kobuki-base/kobuki_resources/marketing/Turtlebot 2 complete kit price for Distributor_150720.pdf

Turtlebot 2 complete kit price for Distributor | 2015.07.20 Written by Min-su
Product | Specification | Quantity | Unit Price (USD) | Remark
Kobuki kit | | 1-99 ea | $280.00 | included Kobuki (base only) / Battery (4S1P) Adapter / USB cable (A type-B type)
| | 100 ea-299 ea | $250.00
| | over 300 ea | $230.00
Poles (include screw) | 14 ea / 1 set | 1 set | $13.00
Dummy Pipe | 2 ea / 1set | 1 set | $4.00
Disk | 3 ea / 1set | 1 set | $26.00
Asus Xtion Pro Mount | | 1 set | $7.00 | 1Disk + 2Poles(include screw)
Netbook | X200MA-KX681D | 1 ea | $450.00 | changeable by device EOL
| Software setting | 1 ea | $100.00
Netbook power cable | - | 1 ea | $10.00
3D sensor | Asus Xtion Pro | 1 ea | $260.00
Total for Turtlebot2 complete kit | | 1-99ea | US$1,150.00
| | 100 ea-299ea | US$1,120.00
| | over 300 ea | US$1,100.00

* Accessaries
Docking station | Docking station | 1 ea | $28.00 | Optional (not included complete kit)
Battery (4S2P) | Battery (4S2P) | 1 ea | $48.00
Caster Wheel | Caster Wheel | 1 Set | $8.00
