kobuki-base/kobuki_resources/hardware/customisations/kobuki_psd_array_brk_90.jpg

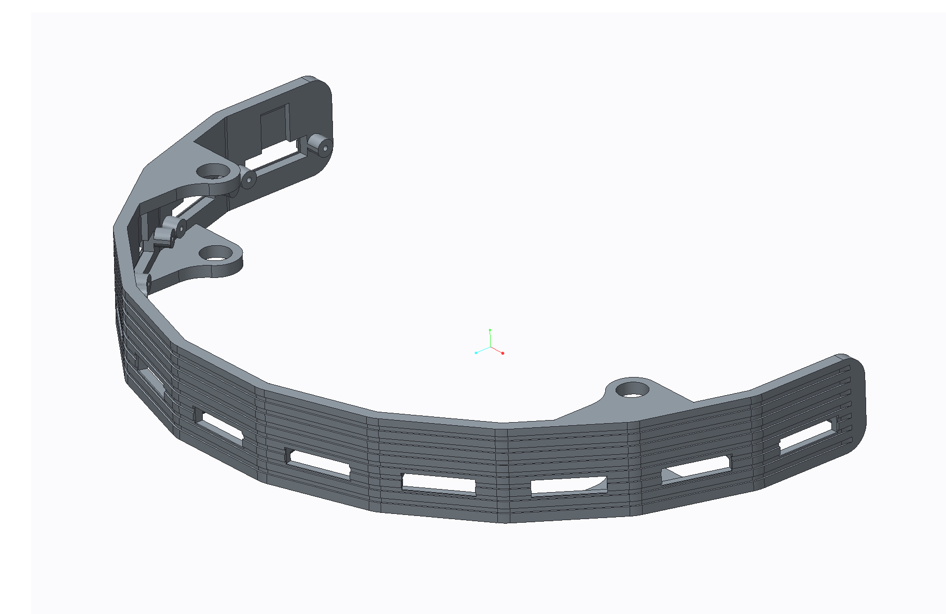
hardware/customisations/kobuki_psd_array_brk_90.jpg
