kobuki-base/kobuki_resources/marketing/icra_roscon.jpg

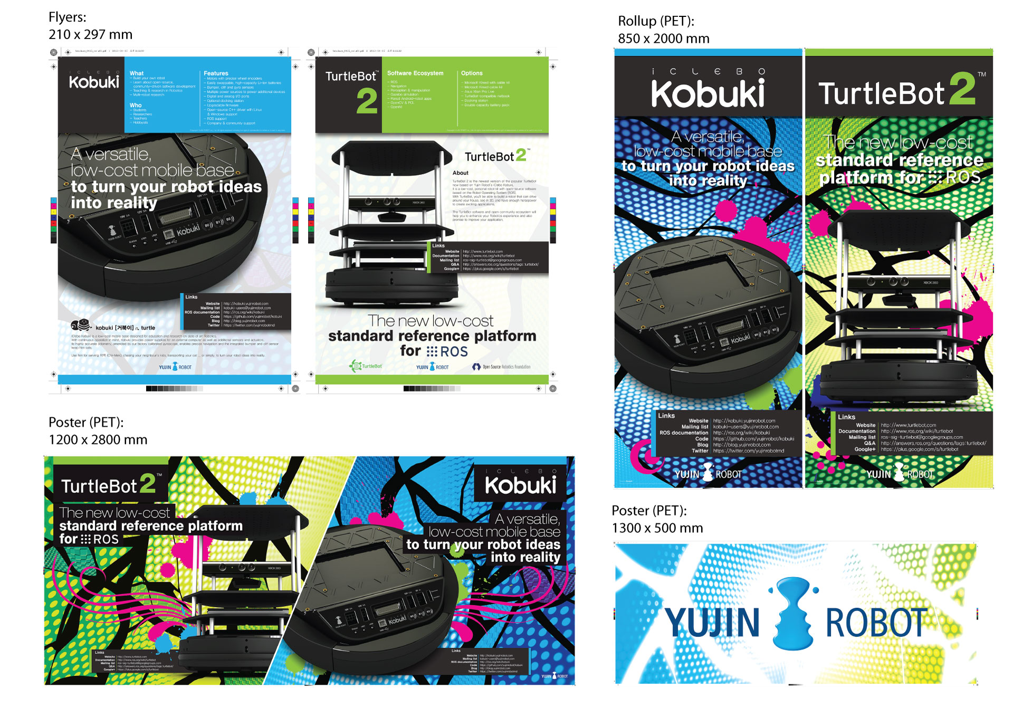
marketing/icra_roscon.jpg
