kobuki-base/kobuki_resources/media/08.jpg

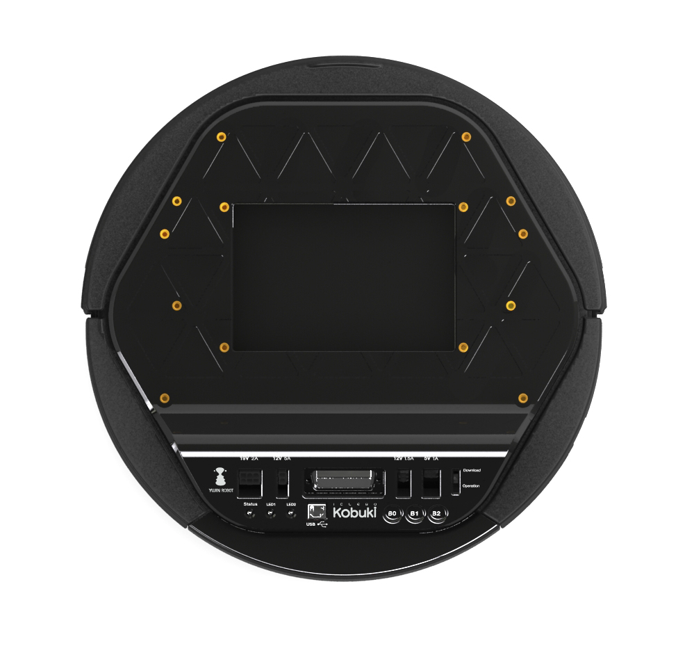
media/08.jpg
