kobuki-base/kobuki_resources/media/big_battery_pack_4S2P.jpg

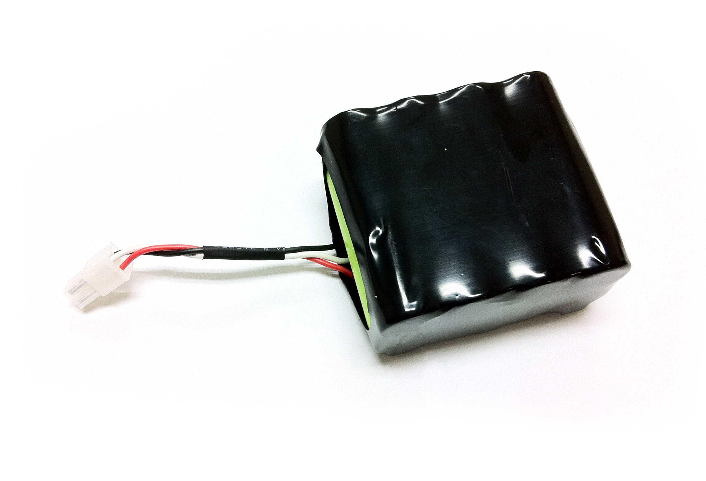
media/big_battery_pack_4S2P.jpg
