kobuki-base/kobuki_resources/media/bottom.jpg

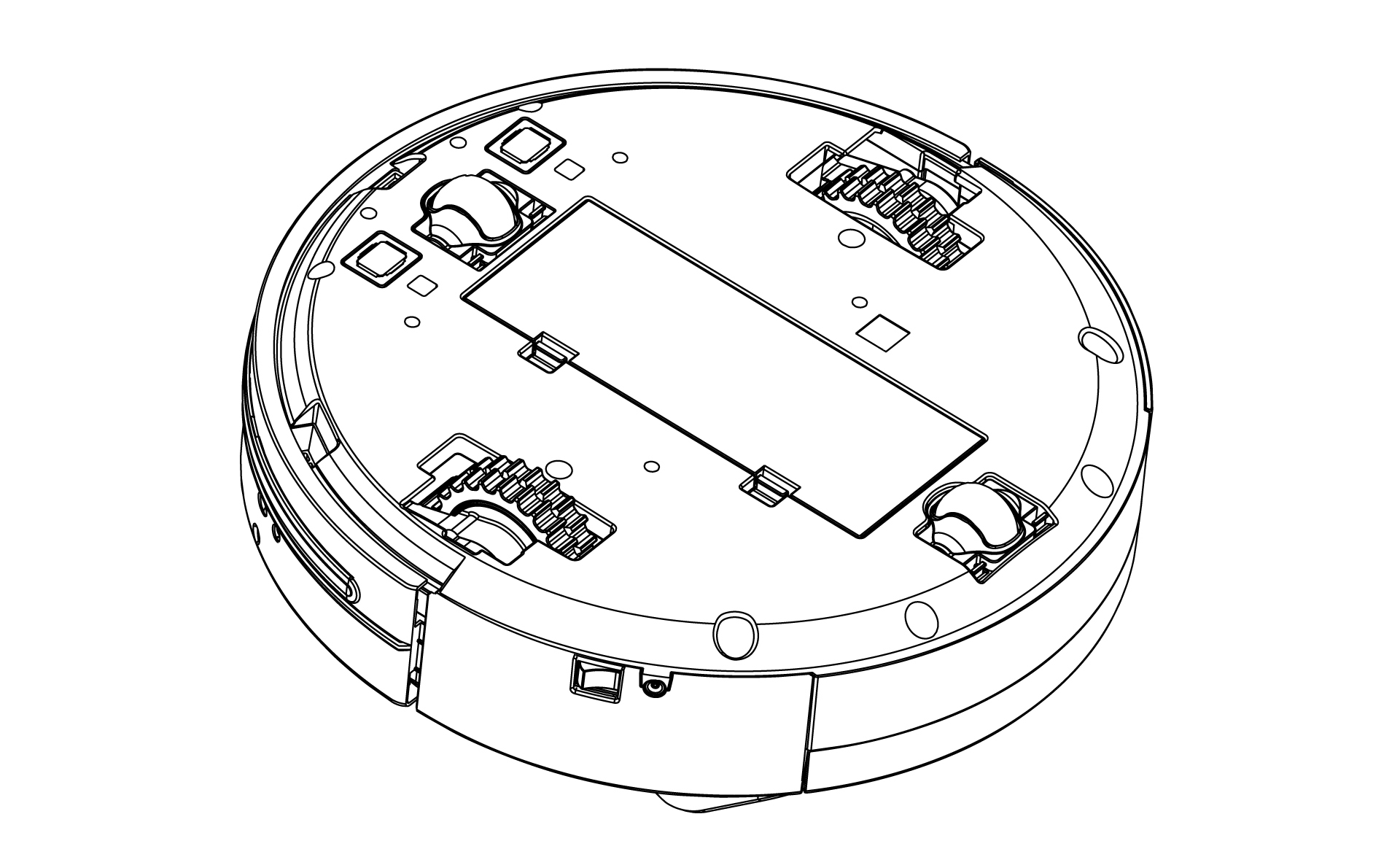
media/bottom.jpg
