kobuki-base/kobuki_resources/media/docking_station_01.jpg

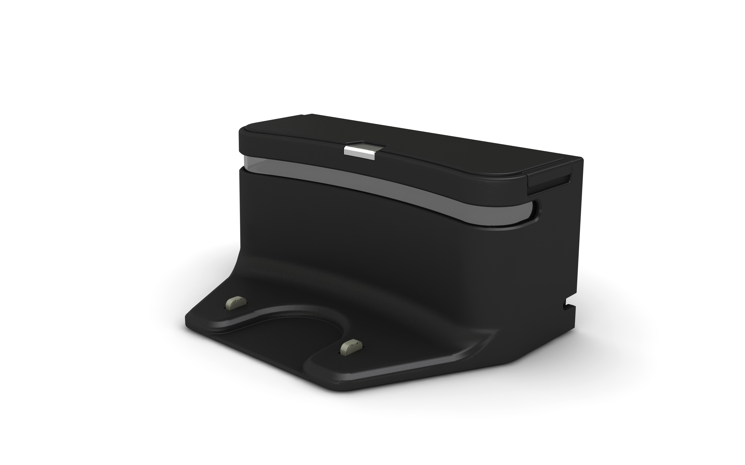
media/docking_station_01.jpg
