kobuki-base/kobuki_resources/media/docking_station_02.jpg

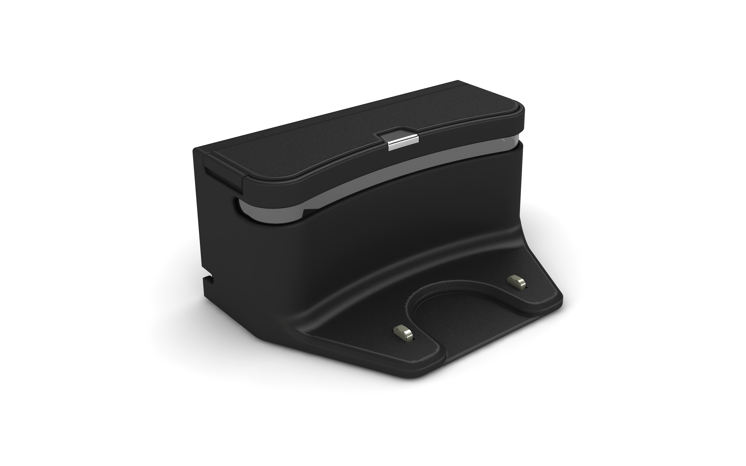
media/docking_station_02.jpg
