kobuki-base/kobuki_resources/media/high-resolution/kobuki-rendering.jpg

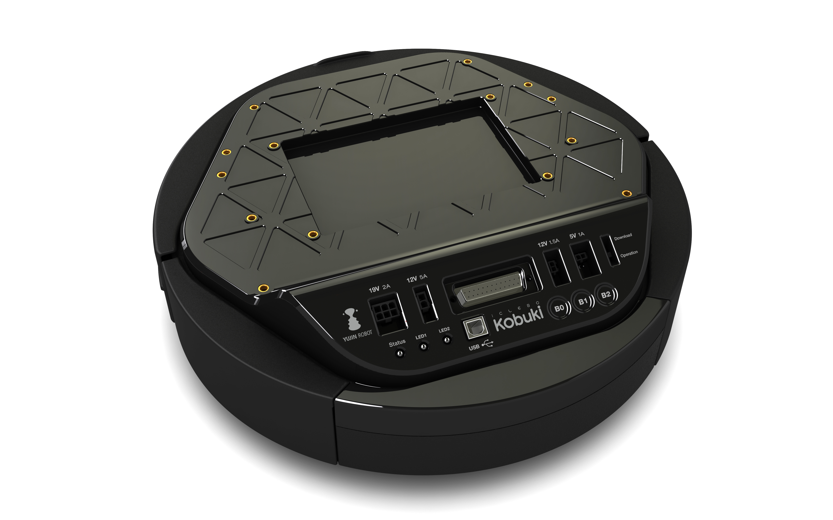
media/high-resolution/kobuki-rendering.jpg
