kobuki-base/kobuki_resources/media/kobuki-rendering.png

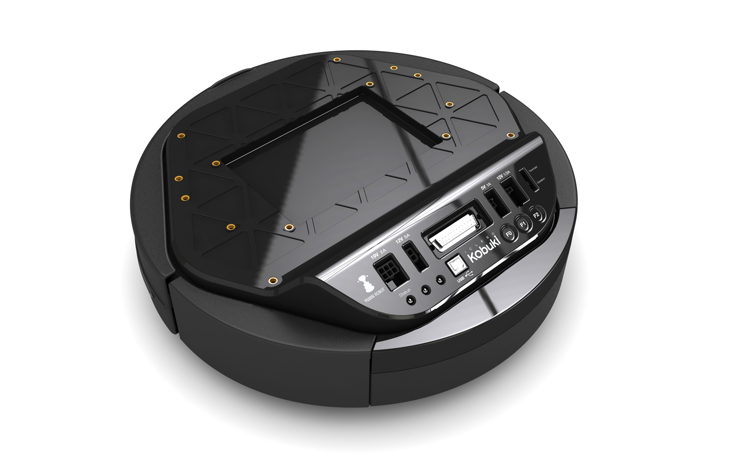
media/kobuki-rendering.png
