kobuki-base/kobuki_resources/media/kobuki_iso_view_01.png

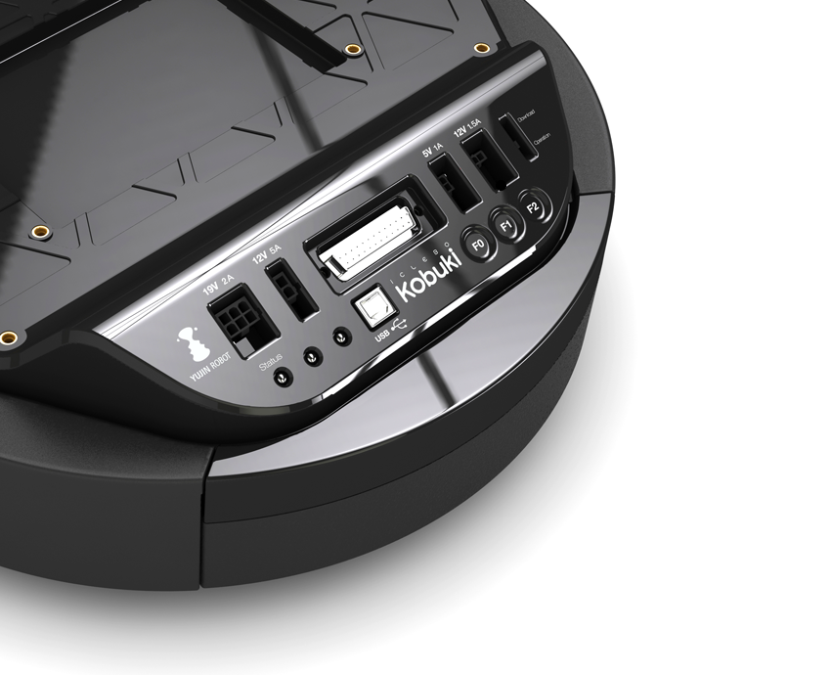
media/kobuki_iso_view_01.png
