kobuki-base/kobuki_resources/media/kobuki_iso_view_02.png

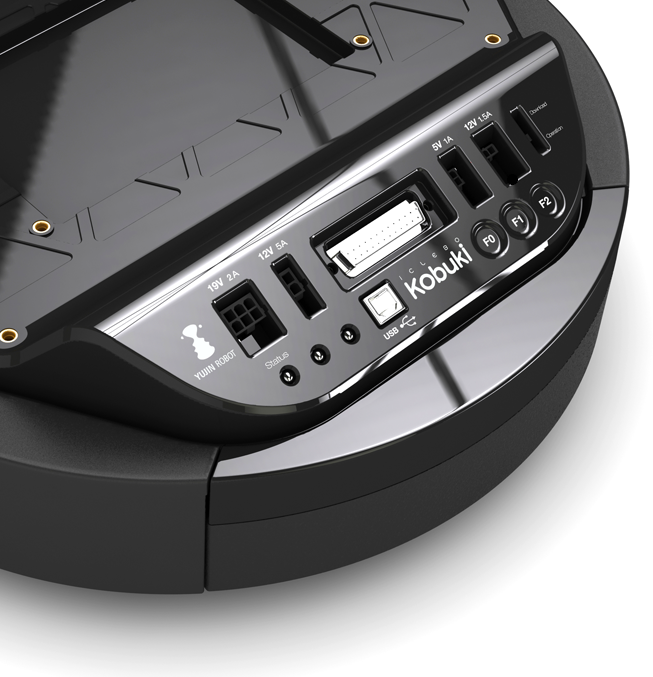
media/kobuki_iso_view_02.png
