kobuki-base/kobuki_resources/media/small_battery_pack_4S1P.jpg

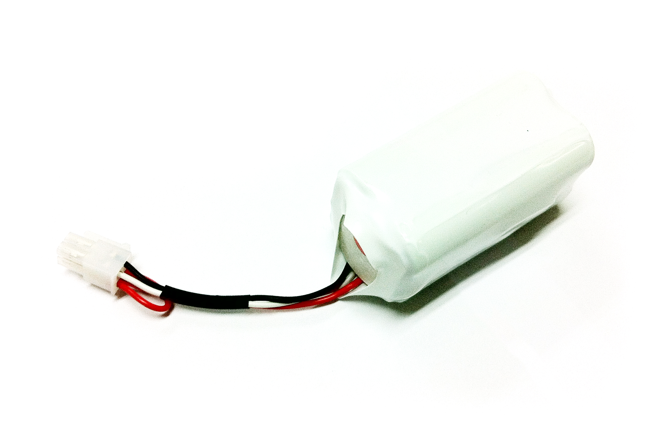
media/small_battery_pack_4S1P.jpg
