kobuki-base/kobuki_resources/media/top.jpg

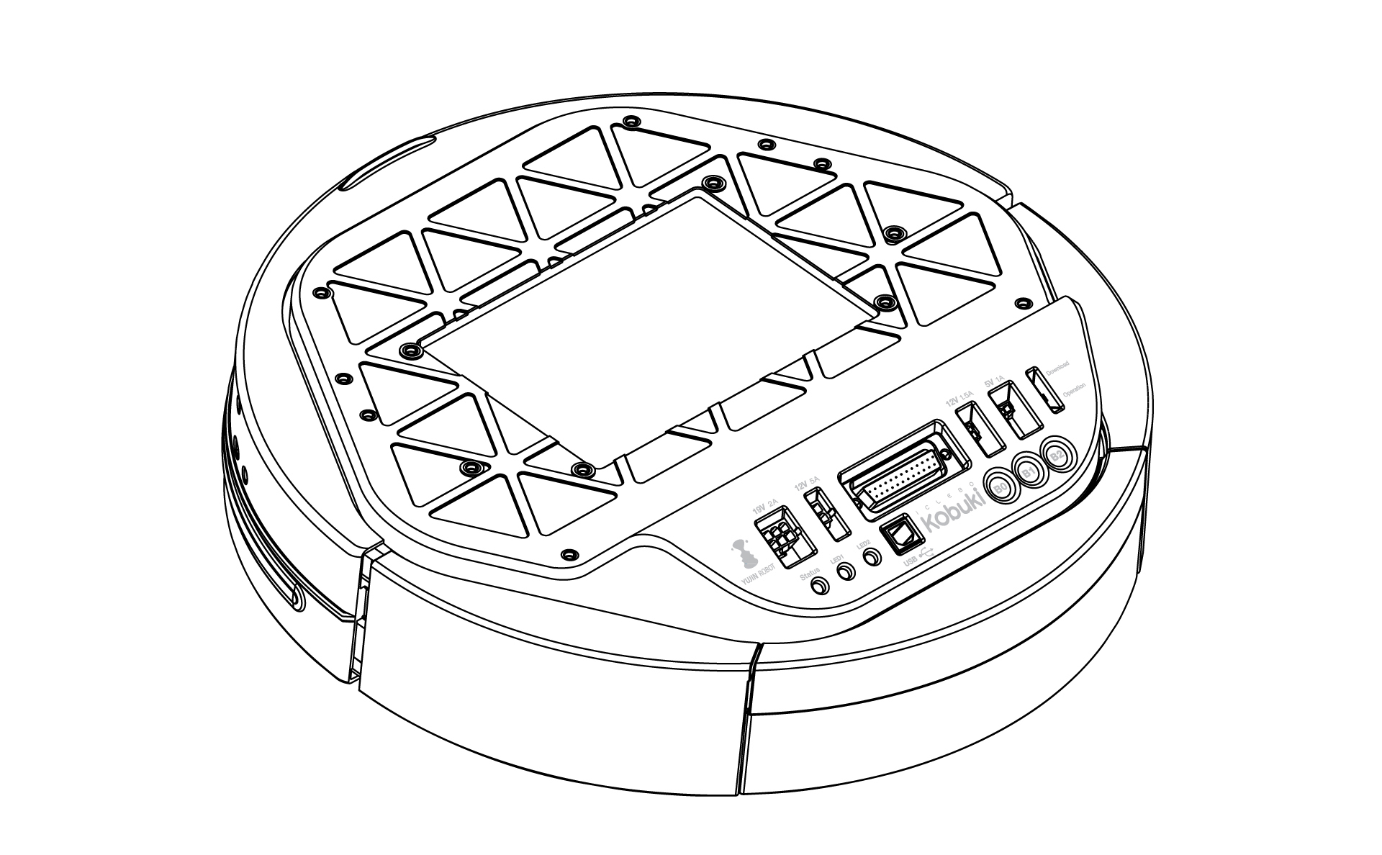
media/top.jpg
