kobuki-base/kobuki_resources/hardware/models/step/plate_bottom.stp

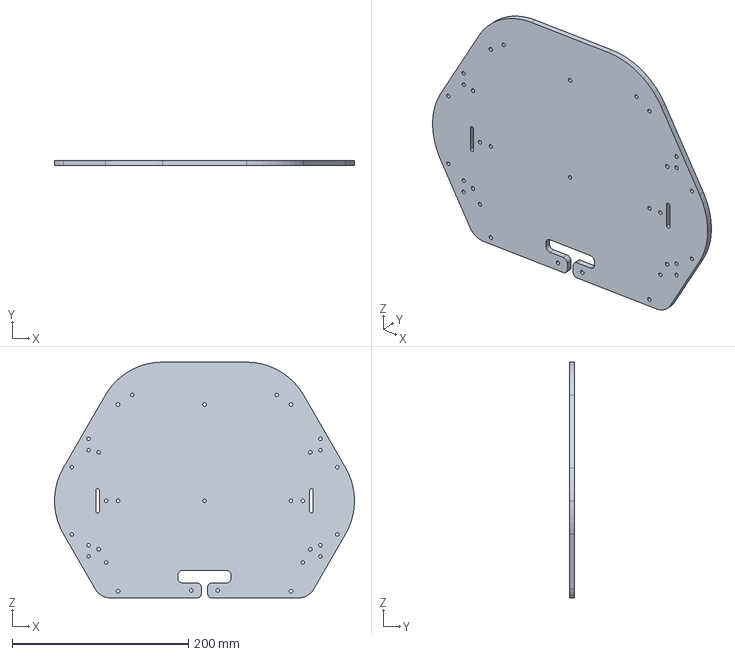
[picture p16: CAD file, 2020-08-19]
hardware/models/step/plate_bottom.stp
340.0 x 6.00 x 267.3 mm
