kobuki-base/kobuki_resources/hardware/models/step/pole_middle.stp

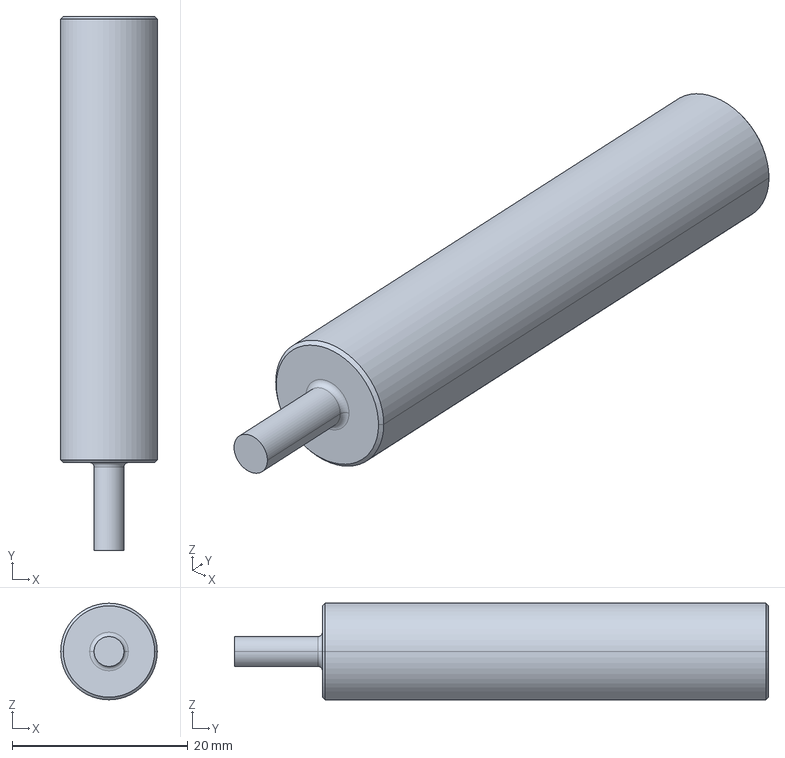
[picture p19: CAD file, 2020-08-19]
hardware/models/step/pole_middle.stp
11.0 x 60.8 x 11.0 mm
