kobuki-base/kobuki_resources/hardware/models/step/pole_bottom.stp

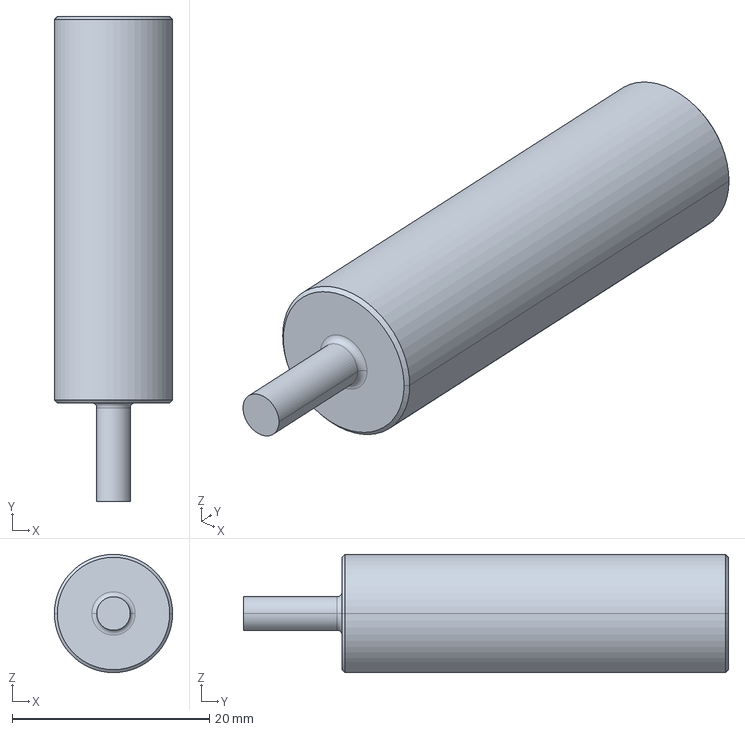
[picture p21: CAD file, 2020-08-19]
hardware/models/step/pole_bottom.stp
12.0 x 49.2 x 12.0 mm
