kobuki-base/kobuki_resources/hardware/models/step/plate_middle.stp

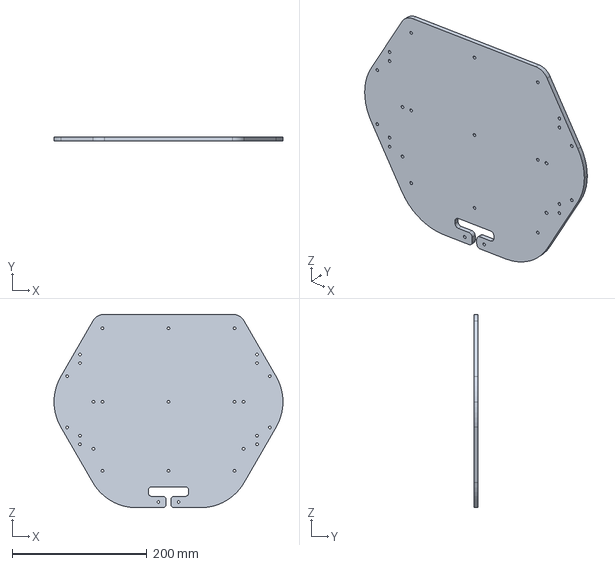
[picture p22: CAD file, 2020-08-19]
hardware/models/step/plate_middle.stp
340.0 x 6.00 x 287.3 mm
