kobuki-base/kobuki_resources/hardware/models/step/kobuki.stp

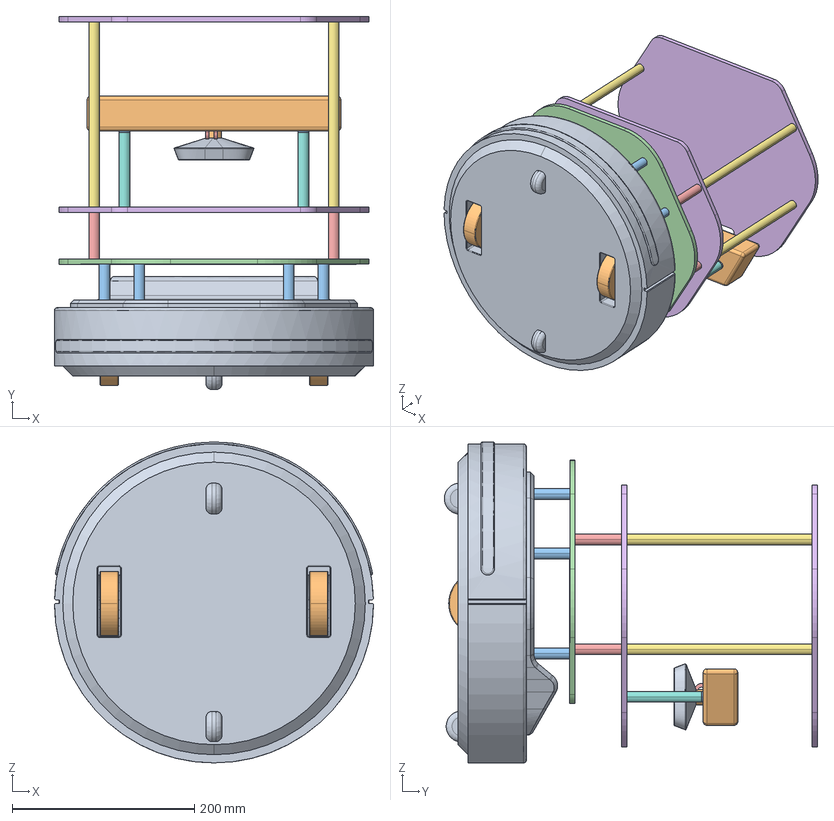
[picture p24: CAD file, 2020-08-19]
hardware/models/step/kobuki.stp
350.0 x 409.6 x 352.0 mm
MAIN_BODY
MAIN_WHEEL_R
MAIN_WHEEL_L
1F_POLL x 6
1F_STACK
2F_POLL x 4
2F_STACK
3F_POLL x 4
3F_STACK
KINECT_POLL x 2
KINECT_M
XTION_POLL x 2
XTION_BRK
XTION-PRO-CAMERA
