kobuki-base/kobuki_resources/(list of files, cad)

Other CAD files:
hardware/drawings/dwg/counterweight.dwg
hardware/drawings/dwg/plate_middle.dwg
hardware/drawings/dwg/pole_top.dwg
hardware/drawings/dwg/pole_kinect.dwg
hardware/drawings/dwg/pole_middle.dwg
hardware/drawings/dwg/pole_bottom.dwg
hardware/drawings/dwg/plate_bottom.dwg
hardware/drawings/dwg/plate_top.dwg
hardware/models/igs/counterweight.igs
hardware/models/igs/plate_bottom.igs
hardware/models/igs/plate_middle.igs
hardware/models/igs/plate_top.igs
hardware/models/igs/pole_bottom.igs
hardware/models/igs/pole_kinect.igs
hardware/models/igs/pole_middle.igs
hardware/models/igs/pole_top.igs
