kobuki-base/kobuki_resources/marketing/kobuki_quickguide_a3.pdf

# Introducing Korea’s First Robotic Turtle!

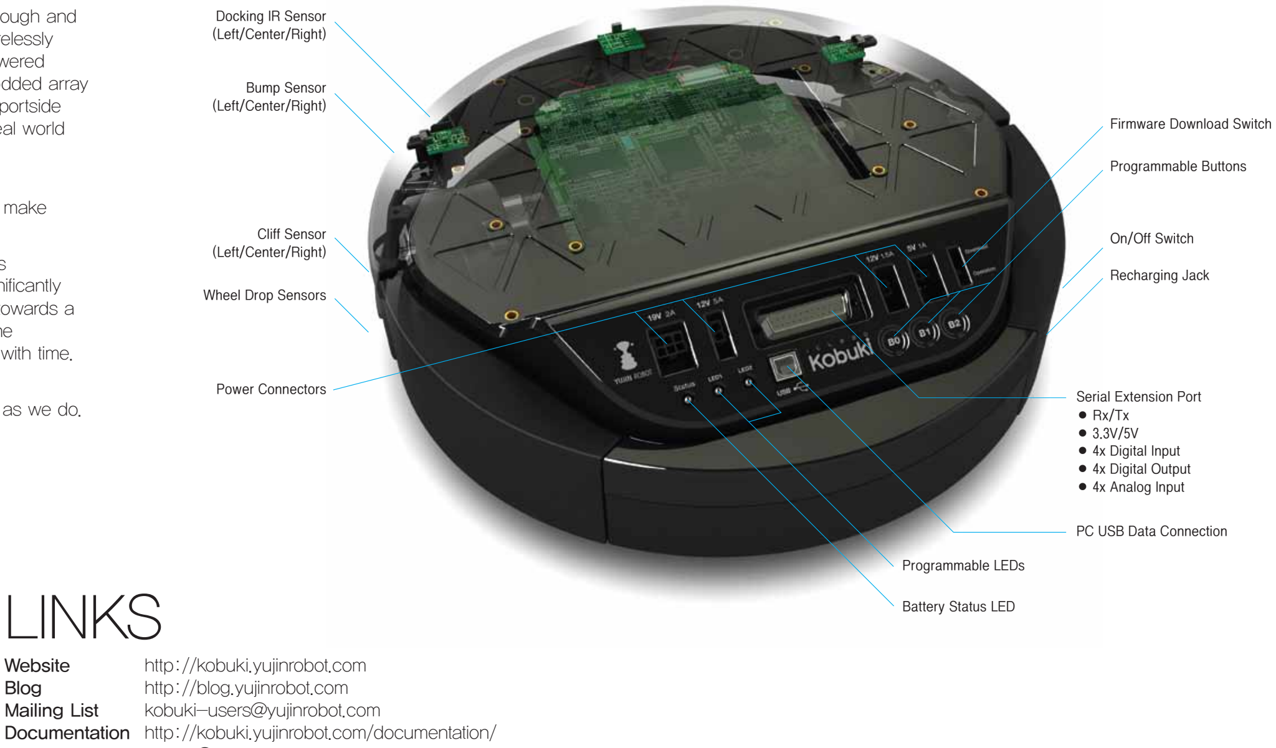
[picture p25: figure]
Recharging Jack; On/Off Switch; Firmware Download Switch; Programmable Buttons; Serial Extension Port ● Rx/Tx ● 3.3V/5V ● 4x Digital Input ● 4x Digital Output ● 4x Analog Input; PC USB Data Connection; Programmable LEDs; Battery Status LED; Cliff Sensor (Left/Center/Right); Bump Sensor (Left/Center/Right); Docking IR Sensor (Left/Center/Right); Wheel Drop Sensors; Power Connectors; Documentation; http://kobuki.yujinrobot.com http://blog.yujinrobot.com kobuki-users@yujinrobot.com http://kobuki.yujinrobot.com/documentation/

Kobuki is robotically engineered to be long-lived, tough and fast. With high performance batteries, Kobuki will tirelessly work alongside you through those long coffee-powered nights. He will happily burden himself with your modded array of sensors, actuators, laptops, embedded boards, portside cannons and do it all at a speed that makes his real world cousins seem like... well, turtles.

# LINKS

Website
Blog
Mailing List

Contact
kobuki@yujinrobot.com
※ For more detailed information about Kobuki including safety instructions and troubleshooting, please check the online documentation.

# CONTENTS

1 x Kobuki
1 x 4S1P Li-Ion Battery
1 x Charger
1 x USB Cable
1 x Power Cable

MADE IN KOREA

Sensorly,
The Kobuki Team

We hope you enjoy working with Kobuki as much as we do.

Kobuki is still young, don’
now. Kobuki’
influenced by the community and as he marches towards a venerable old age, we will continue to work with the community and you to ensure he becomes better with time.

t expect him to remain as
s development has already been significantly

kobuki [거북이] . turtle n

Use him for serving 치맥 (Chi-Mek), chasing your neighbour’
your own robot ideas become reality.

s kids, transport your cat... or simply, to make
