kobuki-base/kobuki_resources/marketing/turtle_quickguide_a3.pdf

# TurtleBot 2

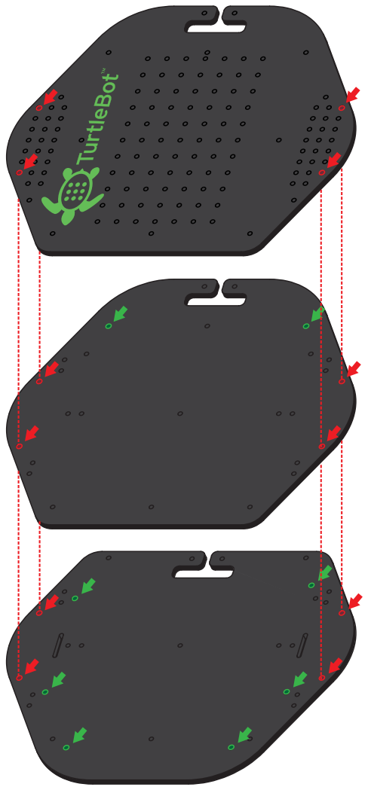
[picture p26: figure]

TurtleBot 2 is the newest version of the popular TurtleBot.
It is a low-cost, personal robot kit with open-source software. With TurtleBot, you'll be able to build a robot that can drive around your house, see in 3D, and have enough horsepower to create exciting applications.
The TurtleBot software and open community ecosystem will help you to enhance your Robotics experience and also promise to improve your application.

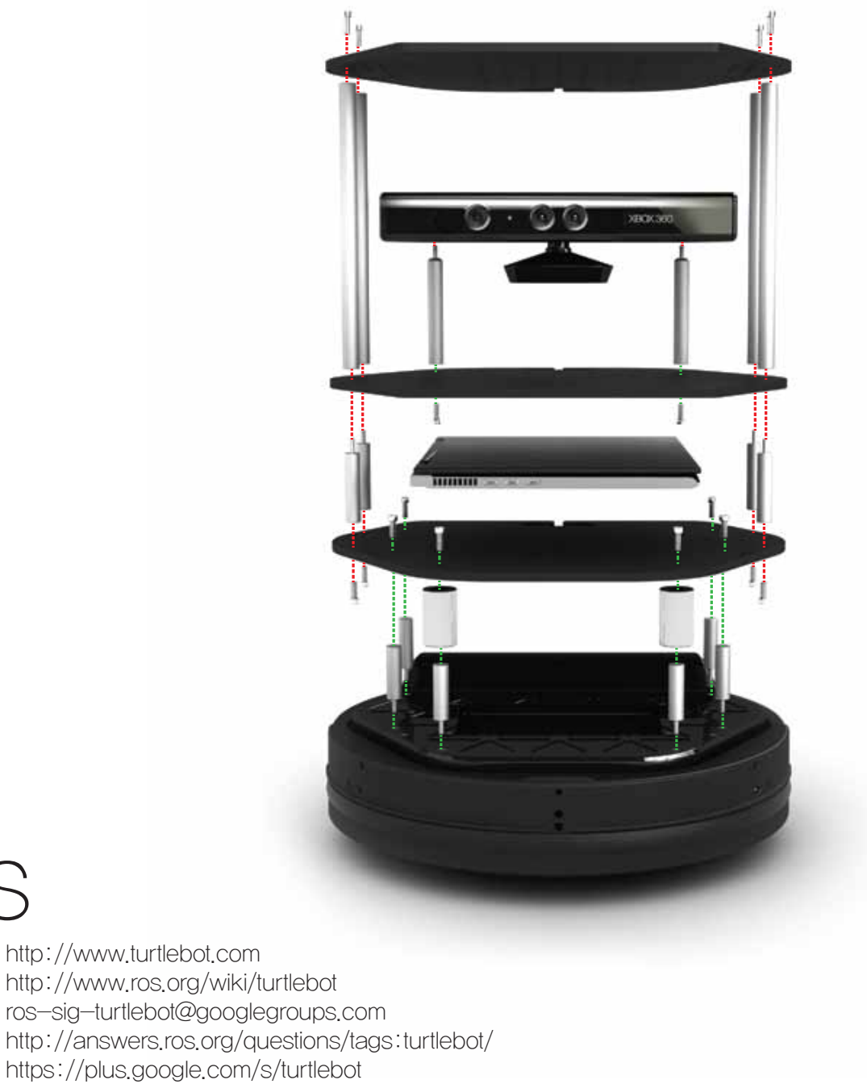
[picture p27: figure]
http://www.ros.org/wiki/turtlebot ros-sig-turtlebot@googlegroups.com; https://plus.google.com/s/turtlebot

# LINKS

Website
Documentation
Mailing List
Q/A
Blog

http://www.turtlebot.com

http://answers.ros.org/questions/tags:turtlebot/

# OPTIONS

Kinect with Modified Cable Kinect Cable Kit
Asus Xtion Pro
Turtlebot Compatible Netbook

# ABOUT

# CONTENTS

1 x Kobuki Complete Kit (Kobuki, Battery, Charger) 1 x Top Plate
1 x Middle Plate
1 x Bottom Plate
4 x 203mm Pole (Top)
4 x 50mm Pole (Middle)
6 x 39mm Pole (Bottom)
2 x 83mm Pole (3D Sensor)
2 x 200g Counterweight
16 x M4 Hex Socket Screw

TM
