kobuki-base/kobuki_resources/(threads)

Thread 1 (2021-01-18):

Docking station mesh?

emersonknapp, 2021-01-18:
I'm trying to build a gazebo plugin to simulate the docking station for the kobuki - it would be nice to have a 3d mesh to represent it accurately. Do you have these resources and could they be shared?

I notice that https://github.com/kobuki-base/kobuki_ros/tree/devel/kobuki_description/meshes has what seem to be some of these resources, translated to collada format. Either format would be fine for my use.

For now I will be representing it as a rectangle :)

emersonknapp, 2021-01-18:
@stonier probably?

emersonknapp, 2021-01-18:
While I'm at it - if there are any materials that define the relative locations of the IR receivers on the kobuki base, that would be helpful so that I could extend the kobuki_description URDF. For now I'm going to try some rough measurements on the actual device and use that to get started.
