kobuki-base/kobuki_resources/hardware/drawings/pdf/kobuki_base_02.pdf

A

1 | 2 | 3 | 4

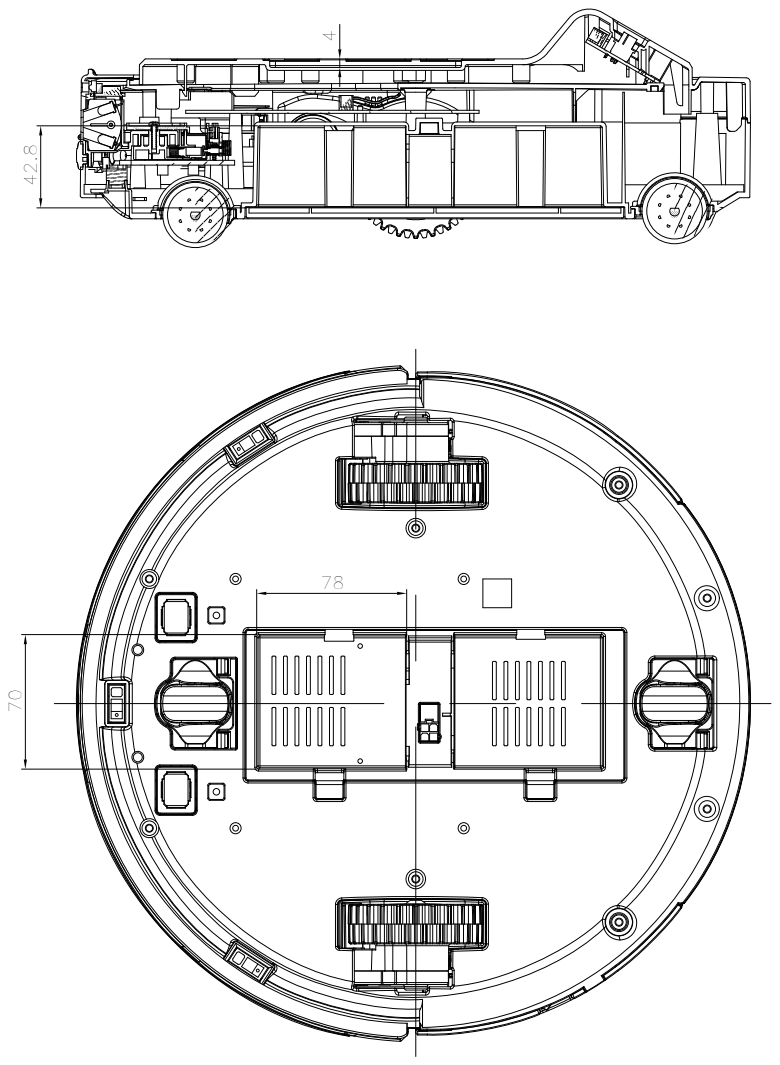
[picture p29: page 1]
CODE No.; PART NAME; DIMENSION; REMARK; SCALE UNIT; DESIGN; REVIEW; APPROVAL; PART; YUJIN ROBOT; MODEL; CODE; MATERIAL; MARK; MODIFICATION; CUASE OF MODIFICATION; DATE; NAME APPROVAL; Kobuki; TURTLE BOT
