kobuki-base/kobuki_resources/hardware/drawings/pdf/plate_bottom.pdf

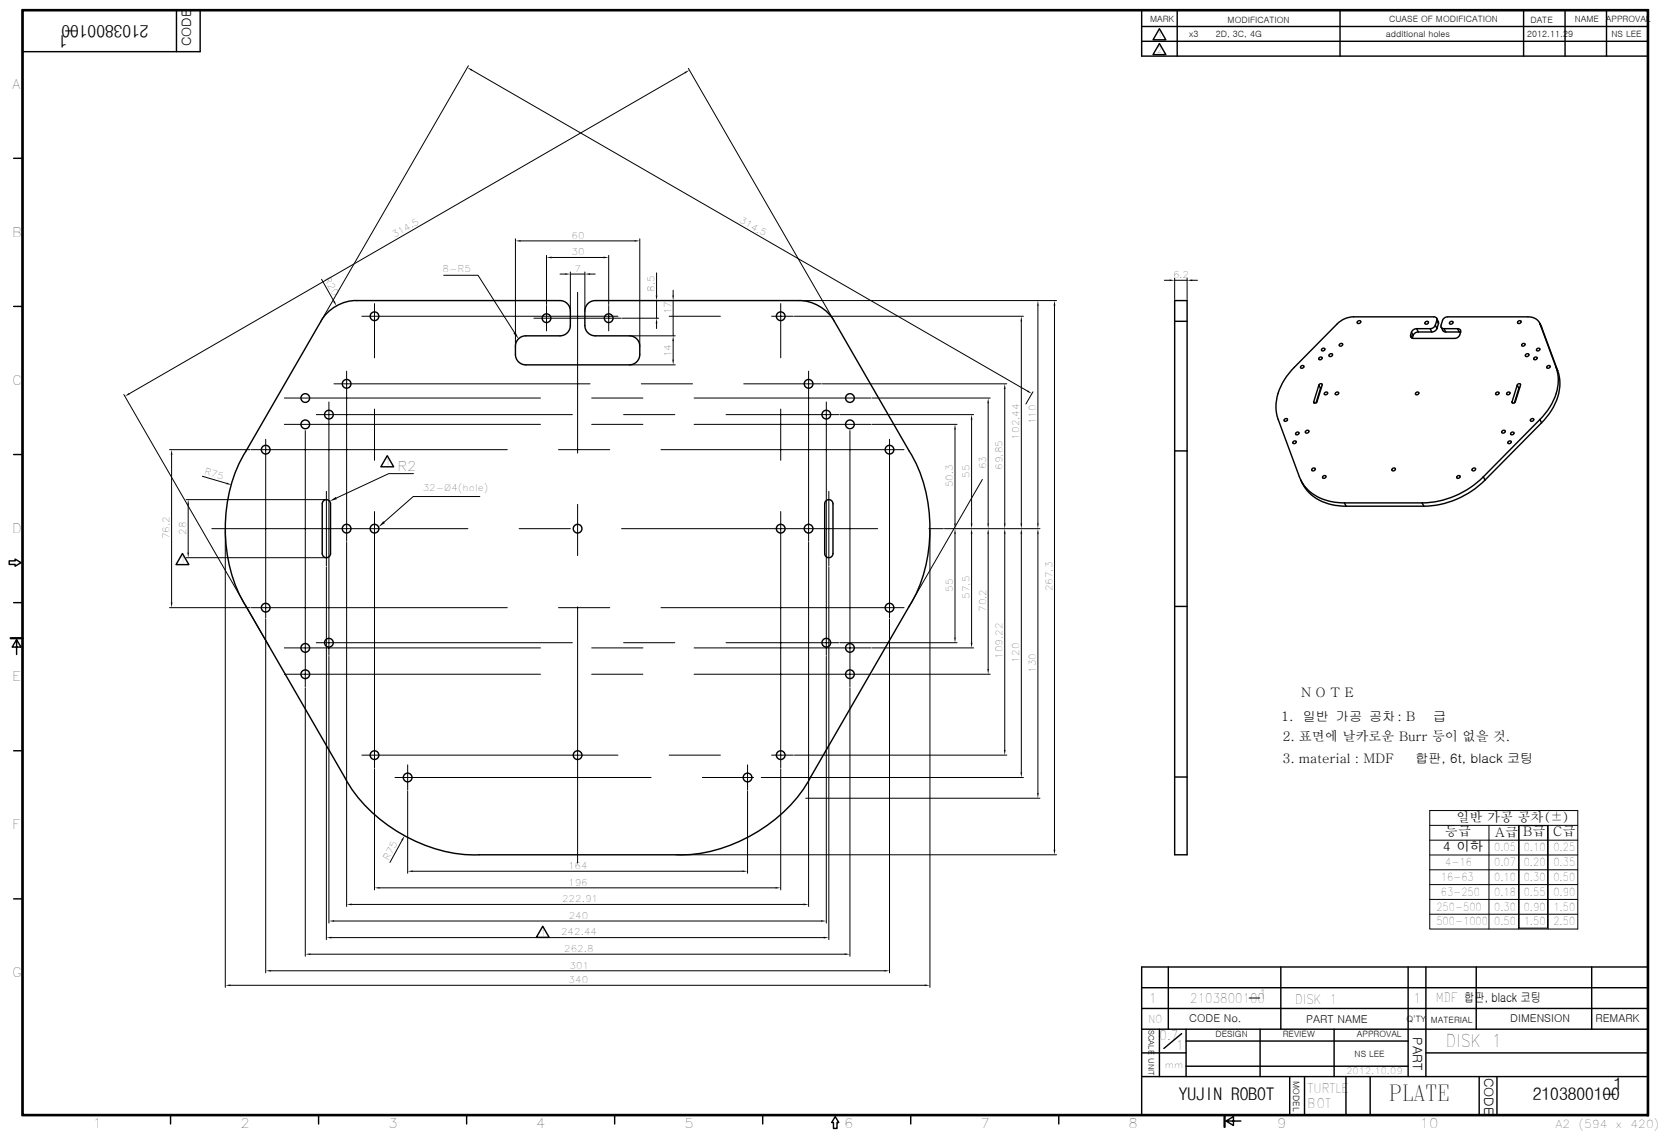
[picture p30: page 1]
CODE; PLATE; CODE No.; PART NAME; DIMENSION; REMARK SCALE UNIT; DESIGN; REVIEW; APPROVAL; PART; YUJIN ROBOT; MODEL; MATERIAL; MARK; MODIFICATION; CUASE OF MODIFICATION; DATE; NAME; NS LEE; additional holes; DISK 1; 3. material : MDF; 합판, 6t, black 코팅; TURTLE BOT

1 R2 32-Ø4(hole)

2. 표면에 날카로운 Burr 등이 없을 것.

MDF 합판, black 코팅
DISK 1
