kobuki-base/kobuki_resources/hardware/drawings/pdf/plate_middle.pdf

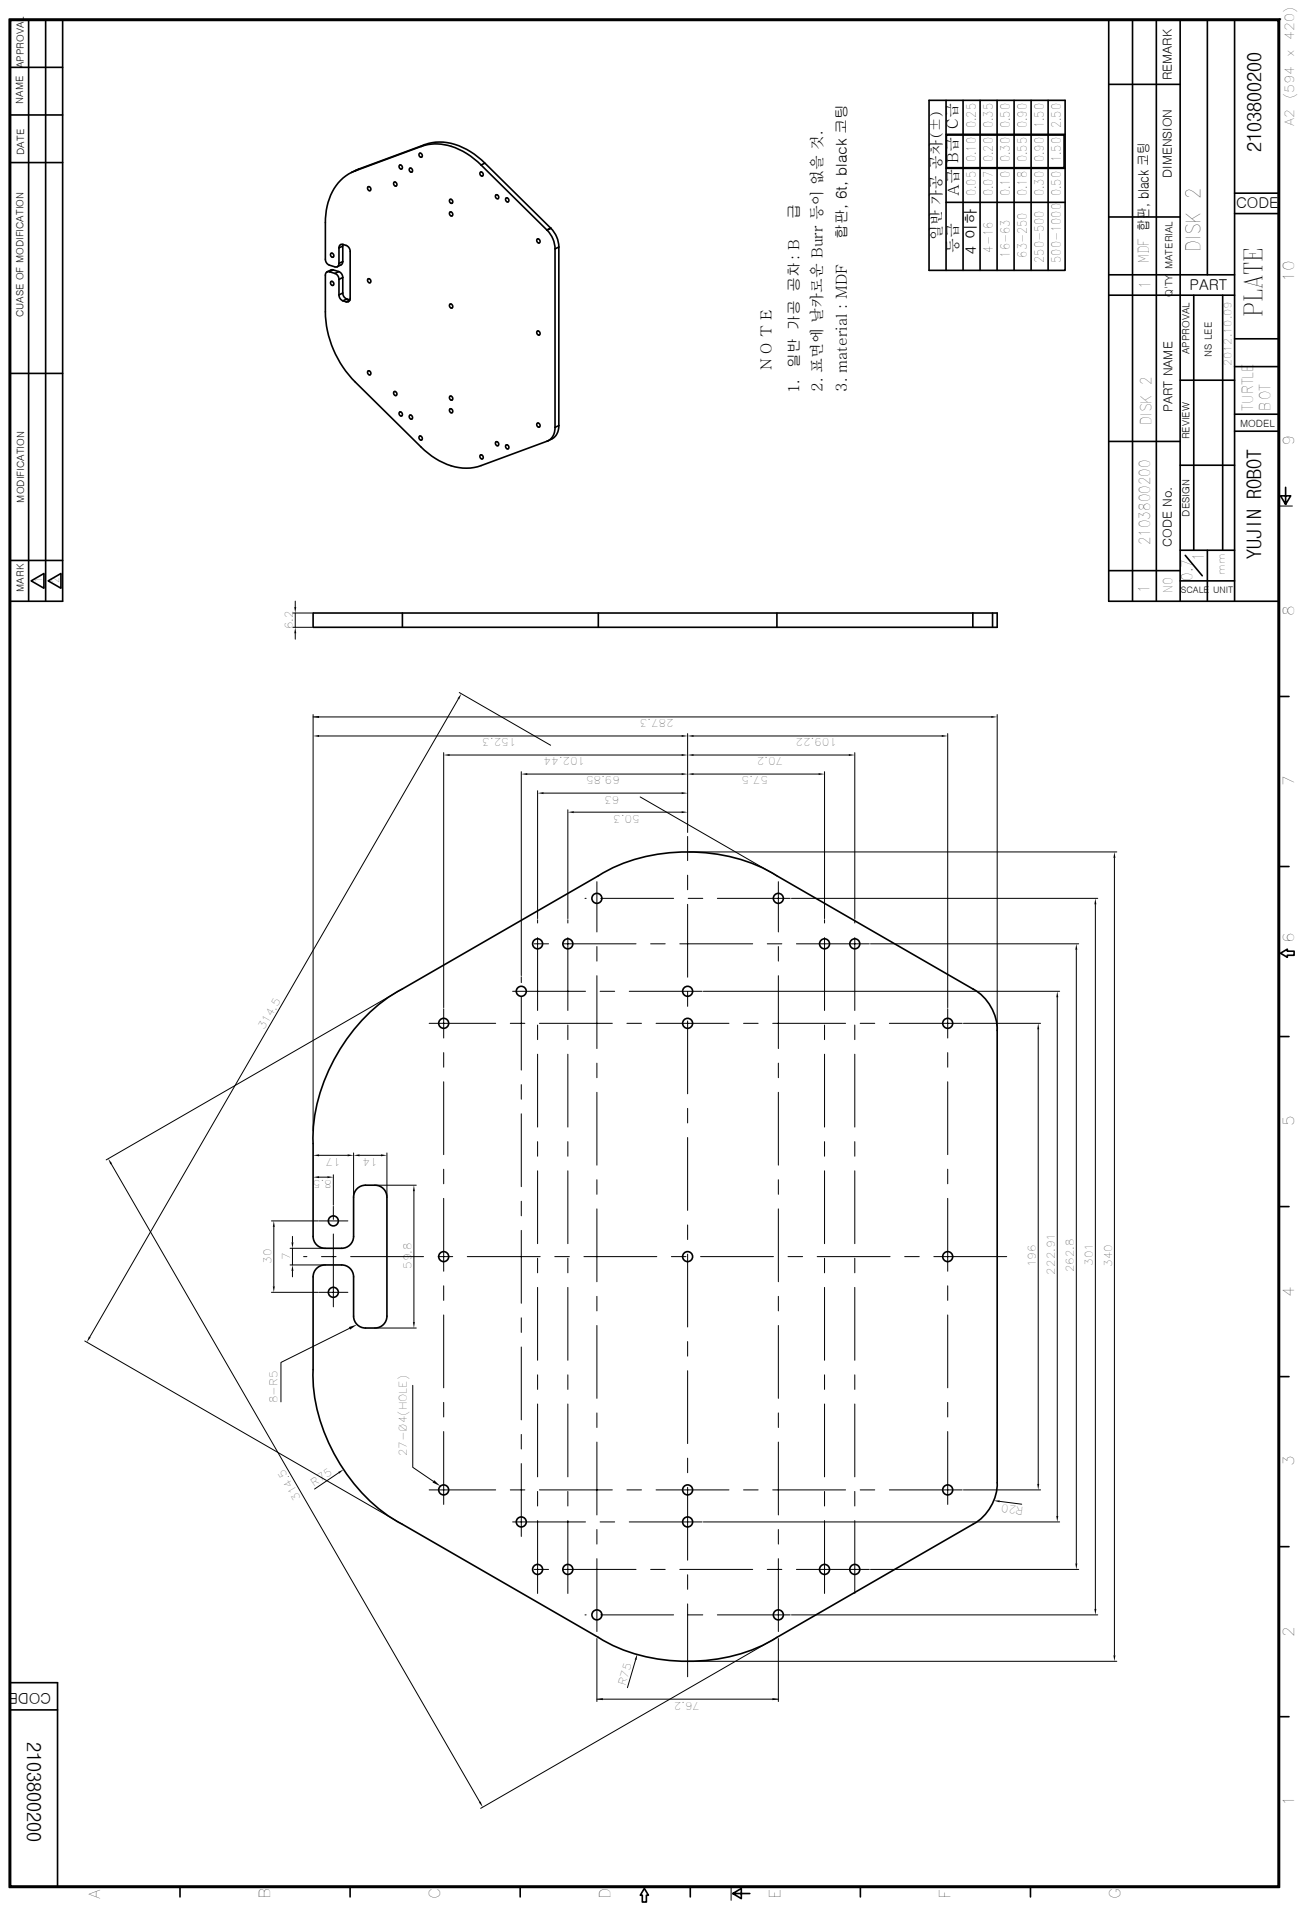
[picture p31: page 1]
PLATE 2103800200; PART; YUJIN ROBOT; CODE; MODEL; MATERIAL; NS LEE; 27-Ø4(HOLE); DISK 2; TURTLE; BOT

MARK CUASE OF MODIFICATION MODIFICATION NAME DATE APPROVAL

PART NAME CODE No. Q'TY DIMENSION REMARK SCALE UNIT DESIGN REVIEW APPROVAL

3. material : MDF 합판, 6t, black 코팅

2. 표면에 날카로운 Burr 등이 없을 것.

MDF 합판, black 코팅
