kobuki-base/kobuki_resources/marketing/121026-brochure_en.pdf

## WHAT

General purpose research platform A component in multi-robot systems

## WHO

Student / Professor
Researcher
ROS beginner
Hobbyist

## High Quality Platform

Motors, battery, base
Various power sources
Multi-OS software drivers
High resolution odometry
Affordable

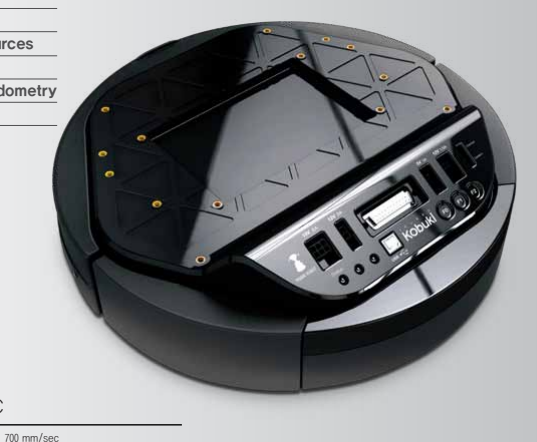
[picture p33: figure]

## Wide community

Web Site
Github
Twitter
Blog
Ros Wiki

http://kobuki.yujinrobot.comhttps://github.com/yujinrobot/kobukihttps://twitter.com/yujinrobotrndhttp://blog.yujinrobot.comhttp://ros.org/wiki/kobuki

Kobuki is an mobile base for open-source research and development purposes.
It can be used to quickly and cheaply build research platforms and also provides access to other open source software, including ROS. The result is a product that can very easily utilise existing 3d sensing technologies and navigation algorithms to develop applications for research.
Max Speed | 700 mm/sec 180 deg/sec
Odometry | 3 axis bulit in gyrometer High resolution wheel encode (11.7 ticks/mm)

Battery

Lithium ion
4S1P (2200 mAh)
4S2P (4400 mAh)
Power source | 5V, 12V, 3.3V
Charging | Robot and Laptop contemporary charge
Firmware upgrade | Supportable

Standard Kit
(Base + Battery + Adapter)

# Kobuki Spec

(Low Price/effective battery system)

world wide distribution

### Motors Battery Various Power Sources Multi-platform High Resolution Odometry Low Price

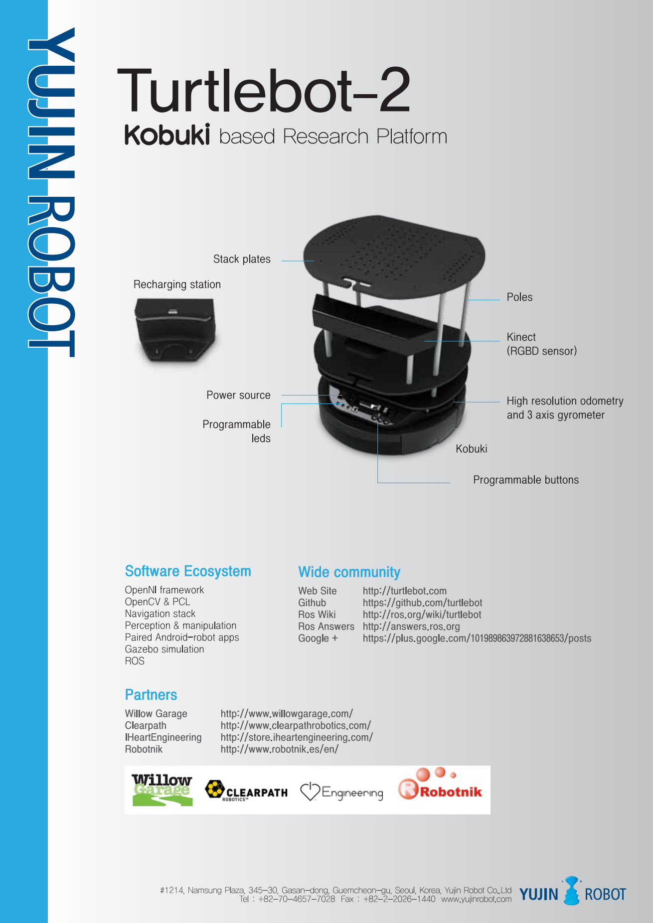
[picture p34: page 2]
