kobuki-base/kobuki_resources/marketing/121026-brochure_ko.pdf

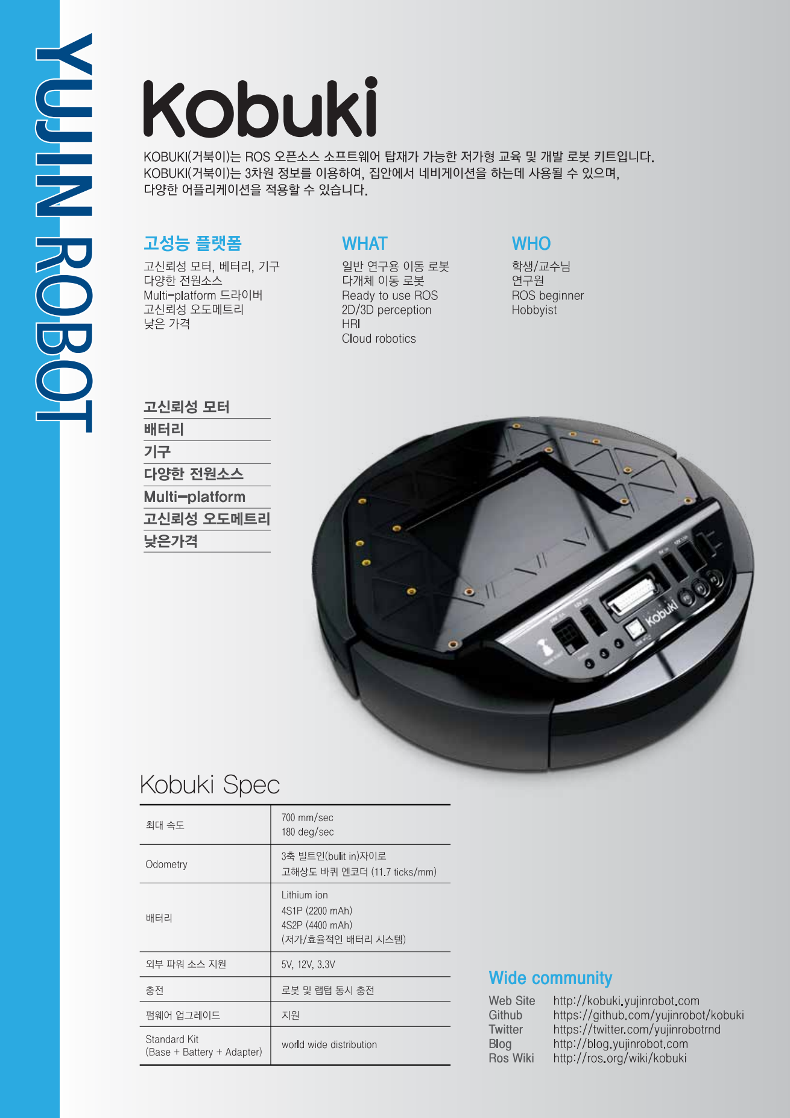
[picture p35: page 1]

# Turtlebot-2

# based Research Platform

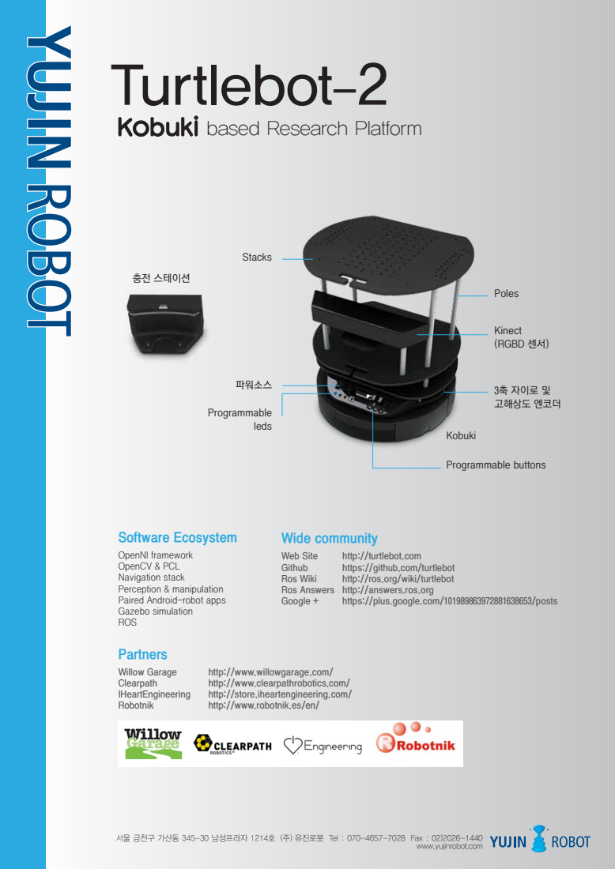
[picture p36: page 2]
Kobuki; Poles; Stacks; 충전 스테이션; 3축 자이로 및 고해상도 엔코더; 파워소스; Programmable leds; Programmable buttons; Kinect (RGBD 센서); Software Ecosystem; Wide community; Web Site Github Ros Wiki Ros Answers Google +; Partners; Willow Garage Clearpath IHeartEngineering Robotnik

OpenNI framework
OpenCV & PCL
Navigation stack
Perception & manipulation
Paired Android-robot apps
Gazebo simulation
ROS

http://turtlebot.com
https://github.com/turtlebot
http://ros.org/wiki/turtlebot
http://answers.ros.org
https://plus.google.com/101989863972881638653/posts

http://www.willowgarage.com/
http://www.clearpathrobotics.com/
http://store.iheartengineering.com/
http://www.robotnik.es/en/

서울 금천구 가산동 345-30 남성프라자 1214호 (주) 유진로봇 Tel : 070-4657-7028 Fax : 02)2026-1440

www.yujinrobot.com
