kobuki-base/kobuki_resources/hardware/specifications/kobuki_battery_4S1P.pdf

## çâ ´úû¶ Æ´†û§°§ûúØ§™©

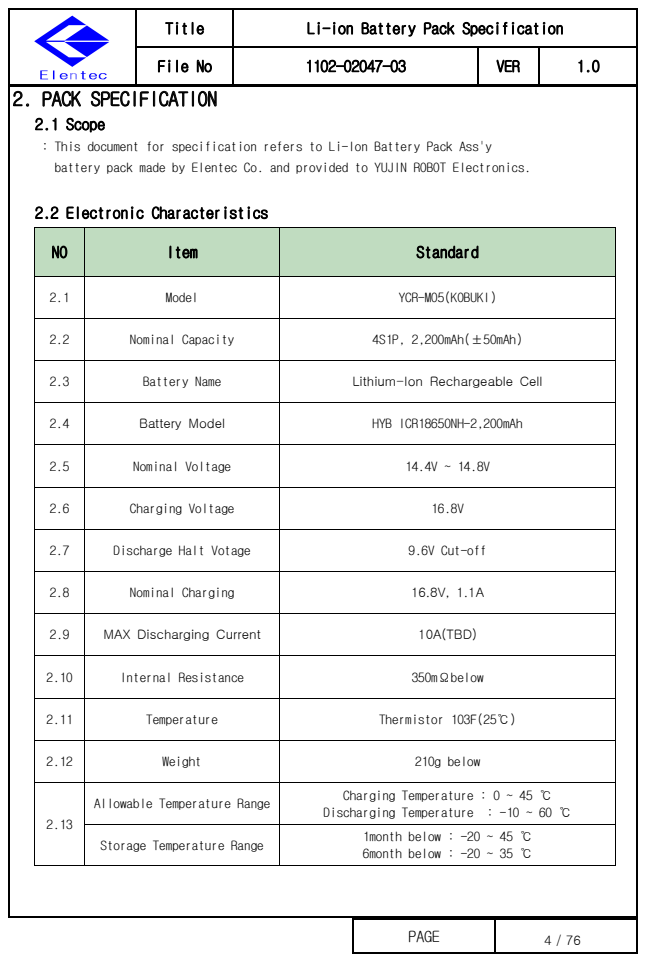
[picture p37: page 1]
[GVG^]GGGGGGGGGGGGG

Øƒœ«¿ | ßƒàƒ … ùºœœ¿Õ‘ ´ºæÆ ÆÀ¿æƒ£ƒæºœƒ …

°ƒ«¿ © | ååãçàãçãèíàãé | ±† | åâã

çâå Ææ À¿
ï ØÃƒŒ ø æ–»¿…œ £ Õ ŒÀ¿æƒ£ƒæºœƒ … Õ¿£¿ÕŒ œ ßƒà§ … ùºœœ¿Õ‘ ´ºæÆ úŒŒÇ‘
½ºœœ¿Õ‘ ÀºæÆ »ºø¿ ½‘ †«¿…œ¿æ û â º…ø ÀÕ —ƒø¿ø œ ¥°•§© ™ù™Ø †«¿æœÕ …ƒæŒâ

çâç †«¿æœÕ …ƒæ ûÃºÕºæœ¿ÕƒŒœƒæŒ

©™ | §œ¿» | Æœº…øºÕø

çâå | ® ø¿« | ¥ûà®ãêÉ¶™ù°¶§Ñ

çâç | © »ƒ…º« ûºÀºæƒœ‘ | èÆå´á çáçãã»úÃÉeêã»úÃÑ

çâé | ùºœœ¿Õ‘ ©º»¿ | sêõèêúîTpñï yåäèàôéåàâìå jåìì

çâè | iàõõåô† tñãåì | £¥ù §ûåìëêã©£àçáçãã»úÃ

çâê | © »ƒ…º« ± «œº¬¿ | åèâè± Ÿ åèâì±

çâë | ûÃºÕ¬ƒ…¬ ± «œº¬¿ | åëâì±

çâí | üƒŒæÃºÕ¬¿ £º«œ ± œº¬¿ | îâë± û–œà ££

çâì | © »ƒ…º« ûÃºÕ¬ƒ…¬ | X]U_}S XUXh

çâî | th kêöäèàôéêïé júôôåïõ | XWhO{ikP

çâåã | §…œ¿Õ…º« ¿ŒƒŒœº…æ¿ | éêã»N½¿« “

çâåå | Ø¿»À¿Õºœ–Õ¿ | ØÃ¿Õ»ƒŒœ Õ åãé°ÉçêEÑ

çâåç | ²¿ƒ¬Ãœ | çåã¬ ½¿« “

çâåé | ú«« “º½«¿ Ø¿»À¿Õºœ–Õ¿ º…¬¿ | ûÃºÕ¬ƒ…¬ Ø¿»À¿Õºœ–Õ¿ ï ã Ÿ èê E üƒŒæÃºÕ¬ƒ…¬ Ø¿»À¿Õºœ–Õ¿ ï àåã Ÿ ëã E

Æœ Õº¬¿ Ø¿»À¿Õºœ–Õ¿ º…¬¿ | å» …œÃ ½¿« “ ï àçã Ÿ èê E ë» …œÃ ½¿« “ ï àçã Ÿ éê E
