kobuki-base/kobuki_resources/hardware/specifications/io_port.pdf

D | D
C | C
B | B
A | A
Date | Ver. | Author | Description | Remark

# iClebo Arte Circuit Release History

2012.4.24 | V0.0.7 | H.J Kim
1. USB type 변경(RA -> ST)
2. FT232RL reset핀에 pull-up 추가
2012.6.14 | V0.0.8 | H.J Kim | 1. J46 커넥터 통합
1. J21, J22, J37, J45 커넥터 타입 변경(with snap-in)
2. J20 커넥터 bottom면 실장
3. usart3 esd protection 추가
4. DB25_ENABLE 핀 회로추가
5. VDD_5V, VBUS간 BEAD 삭제
2012.7.29 | V0.9.0 | H.J Kim

## 1. J46핀맵 변경

2. J21, J22 molex 커넥터 고정핀에 솔더링 패드 추가(artwork)

## 3. J20 커넥터 안쪽으로 최대한 이동(artwork)

4. L6 초크 코일 위치 이동(artwork)
2012.9.11 | V0.9.1 | H.J Kim

### KINECT_12V: 1.5A EX_5V : 1A

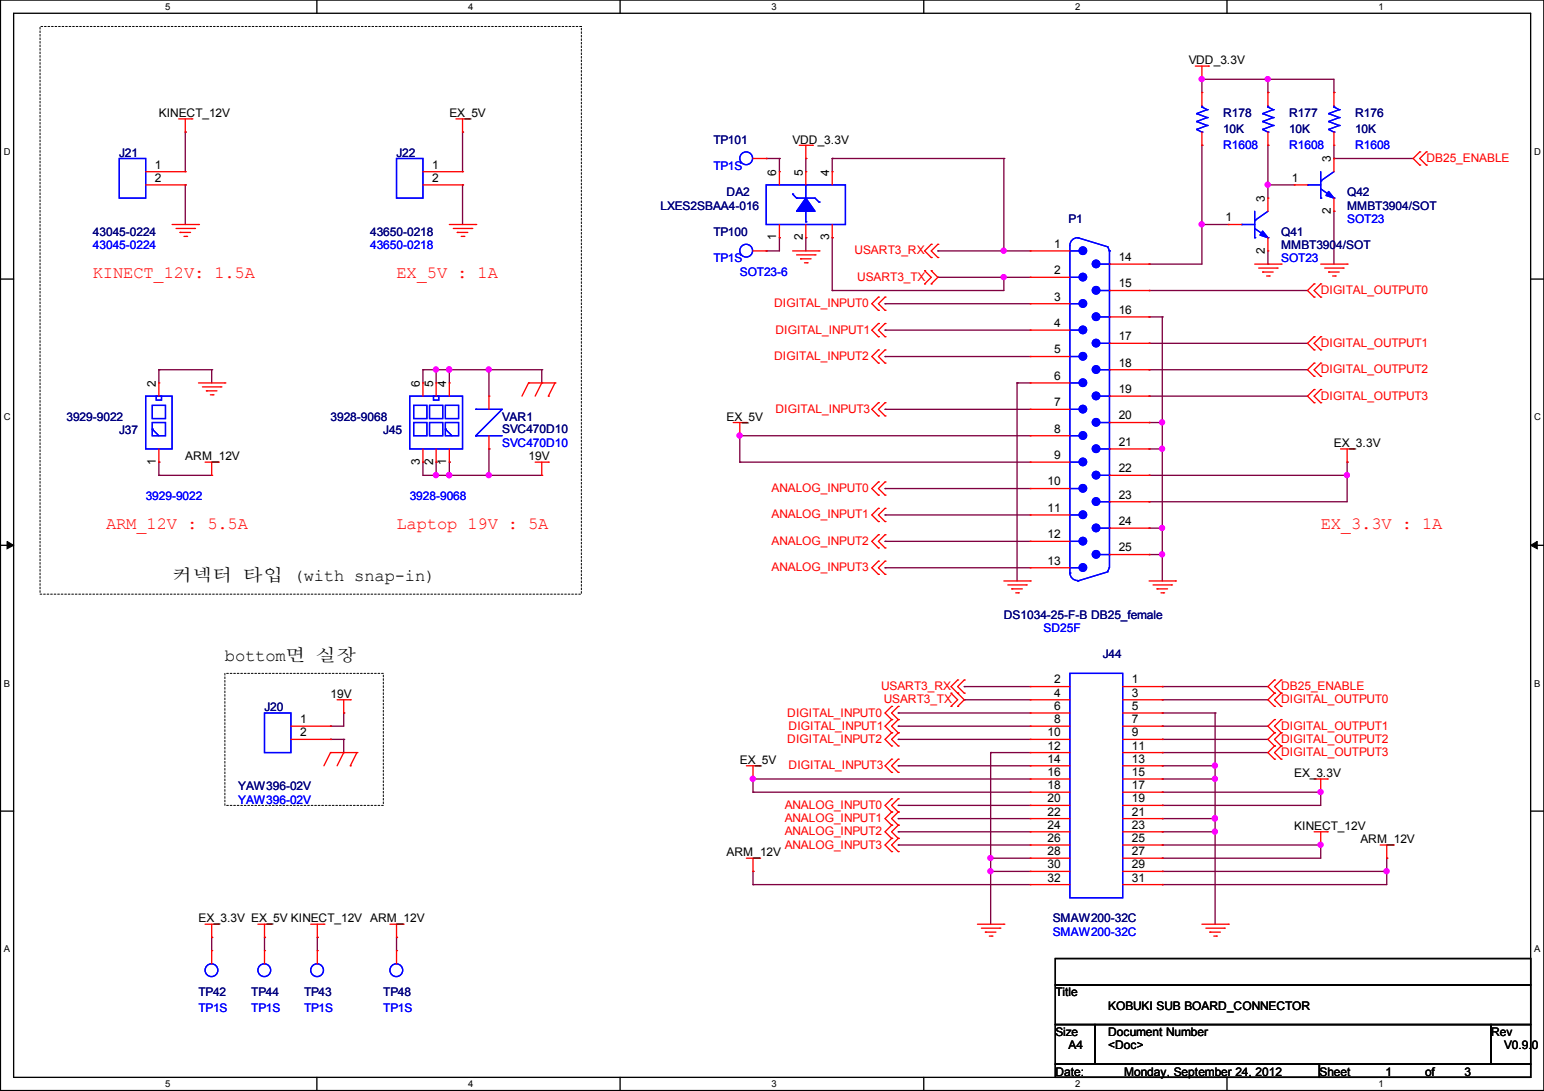
[picture p38: page 2]

커넥터 타입 (with snap-in)

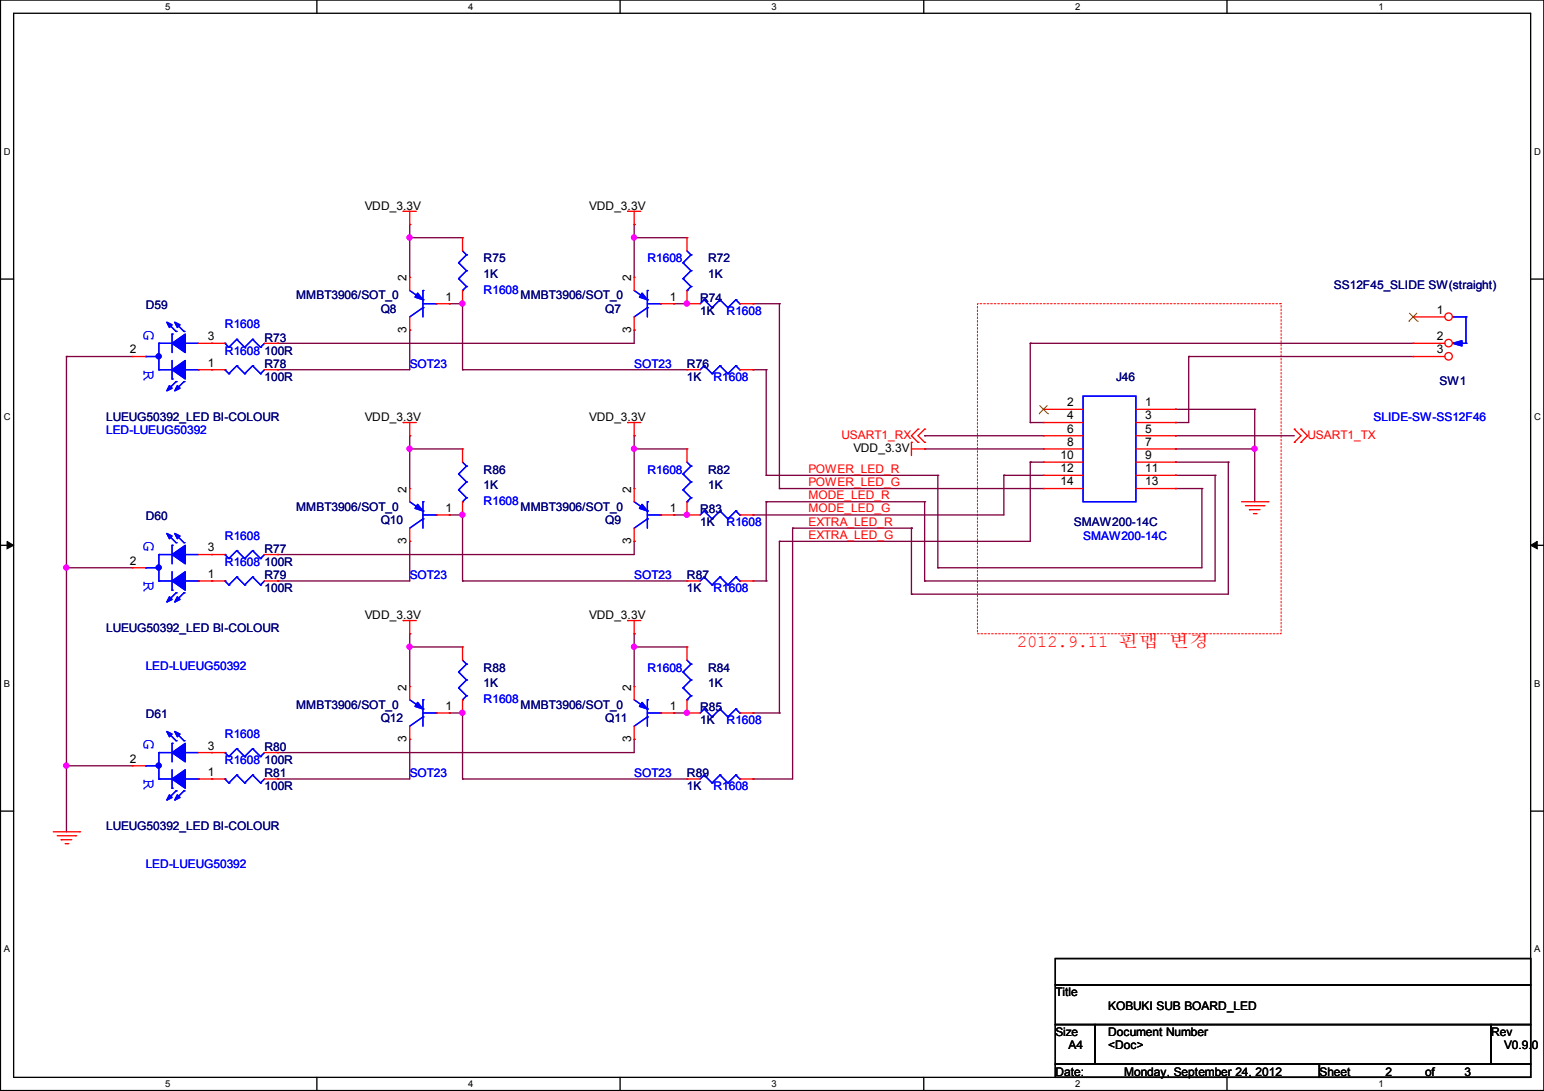
[picture p39: page 3]

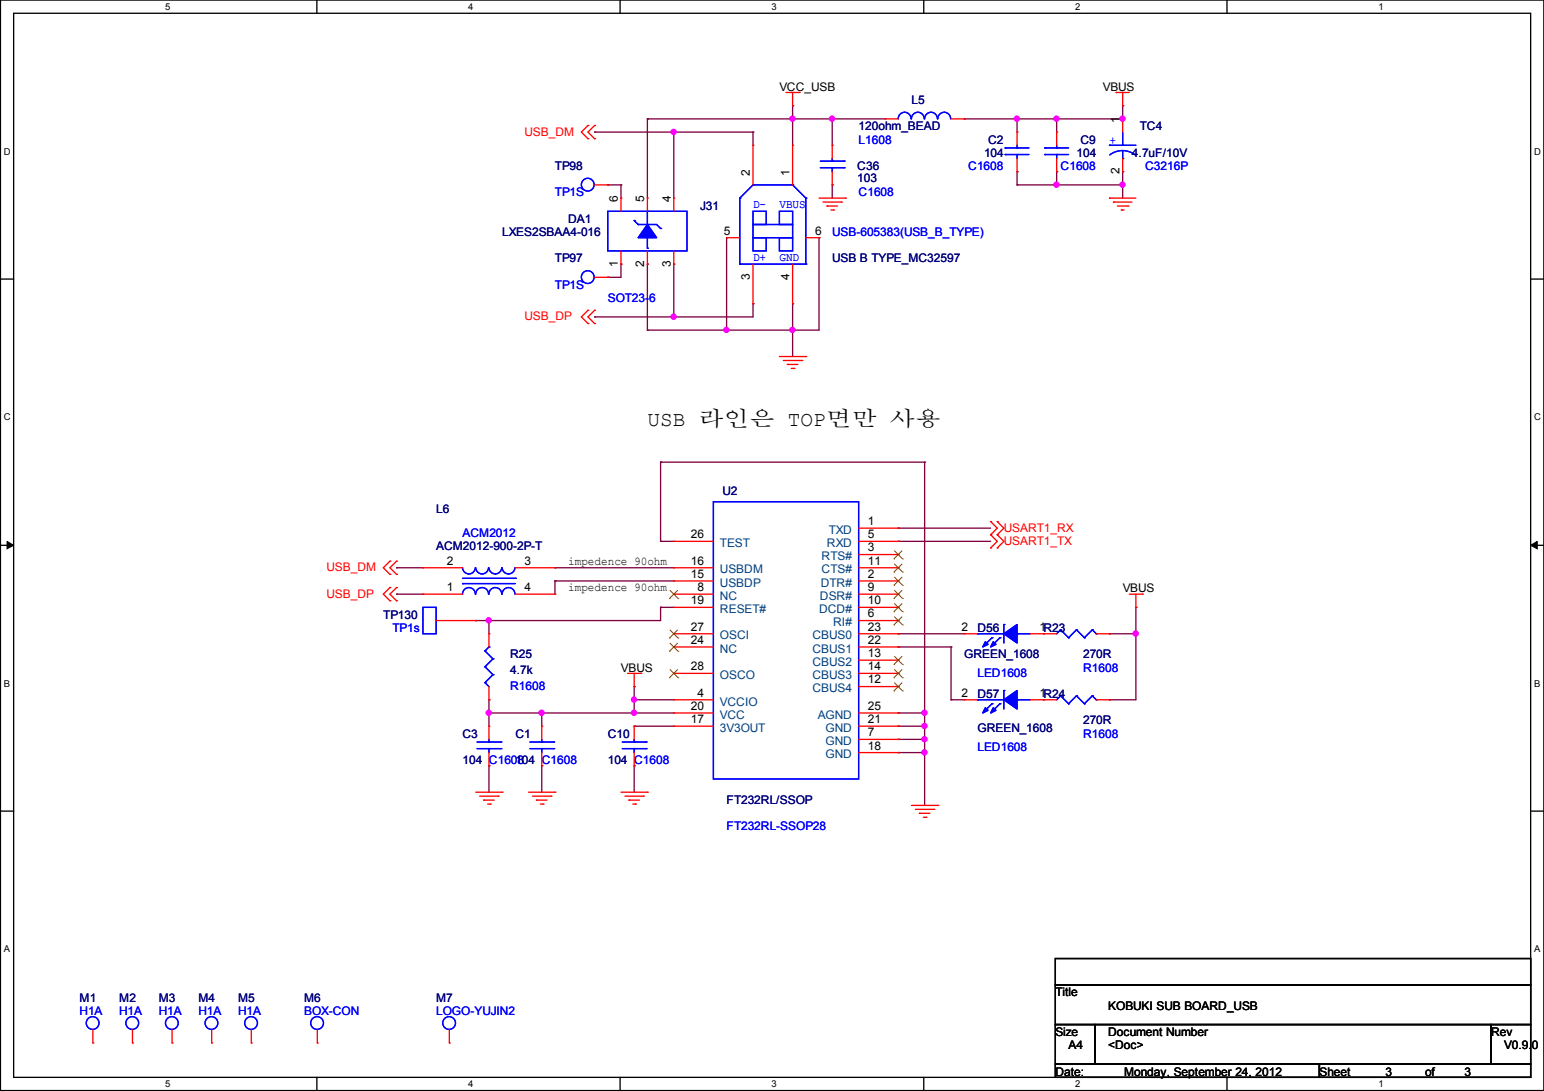
[picture p40: page 4]

USB 라인은 TOP면만 사용
