kobuki-base/kobuki_resources/hardware/drawings/pdf/pole_bottom.pdf

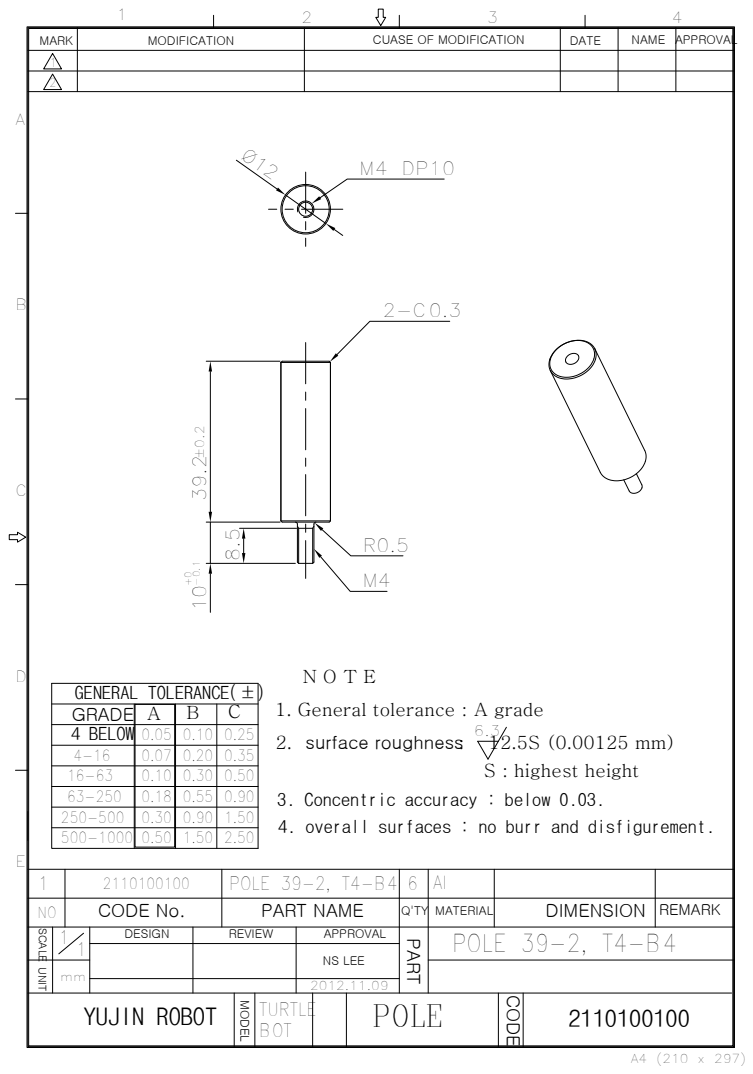
[picture p41: page 1]
POLE; CODE No.; PART NAME; DIMENSION; REMARK; SCALE UNIT; DESIGN; REVIEW; APPROVAL; PART; YUJIN ROBOT; MODEL; CODE; MATERIAL; MARK; MODIFICATION; CUASE OF MODIFICATION; DATE; NAME; NS LEE; POLE 39-2, T4-B4; GENERAL TOLERANCE(±) GRADE 4 BELOW; 2. surface roughness :; S : highest height; TURTLE BOT

1. General tolerance : A grade

0.05 | 0.10 | 0.25
0.07 | 0.20 | 0.35
0.10 | 0.30 | 0.50
0.18 | 0.55 | 0.90
0.30 | 0.90 | 1.50

3. Concentric accuracy : below 0.03.
4. overall surfaces : no burr and disfigurement.
