kobuki-base/kobuki_resources/(commit log)

2020-08-19 [hardware] added and readme updated
    [counterweight.dwg, counterweight.igs, counterweight.stp, kobuki.stp, plate_bottom.dwg, plate_bottom.igs, plate_bottom.stp, plate_middle.dwg]
2020-08-19 [hardware] battery 4S1P specification
2020-08-21 [media] images of all thigns kobuki, used in marketing materials
